barlowtj48/MIDI-Stepper-Motor-Music/(threads)

Thread 2 (2023-11-18):

Request for sample files

richardguerre, 2023-11-18:
Hi @barlowtj48, really cool project! I'm on a Mac so I can't use LoopMidi, so I modified the python script to accept a MIDI file directly, but it's not that fast for experimenting. Do you have the MIDI file you used for the Son of Flynn cover you made on TikTok (so cool btw)?

barlowtj48, 2023-11-18:
Yeah! I added the two Tron tracks that I made, and also the Mario Star Power one too

Closed 2023-11-21.

Thread 4 (2024-01-02):

Problem with 1 channel of CNC shield

DavidShoe, 2024-01-02:
Configured everything (I think), and when I run the sample FL project 3 of the channels (X,Y,Z) all seem to be working as expected.  But the A channel doesn't turn the stepper.

I have swapped the driver module / cables and motor and it seems to be an issue with the A channel configuration.  Is there anything different I need to do with it?

This is a Mega 2560 using a CNC shield and 4 A4988 drivers.

levfo, 2024-01-11:
Having the same issue! Nothing from Channel A

barlowtj48, 2024-01-15:
Sorry for the delay. I will be updating the instructions to note the extra pins that are needed to enable the A stepper driver "direction" and "step" output.

barlowtj48, 2024-01-15:
Added documentation for this issue. Tested and confirmed that without the leads plugged in the "A" driver fails to output.
New photo can be found in [Hardware Assembly Section](https://github.com/barlowtj48/MIDI-Stepper-Motor-Music?tab=readme-ov-file#hardware-assembly)

Closed 2024-01-15.

Thread 6 (2024-01-05):

loopMIDI alternative for Mac or Windows ARM?

Rocky56gh9, 2024-01-05:
Hi - awesome project! I'm running an M2 Mac with Windows 11 ARM installed, and loopMIDI is incompatible with that version of Windows. Do you happen to have any thoughts on alternatives that would work on ARM, either Windows or Mac? Thanks!

Rocky56gh9, 2024-01-05:
I found this, but have no idea where to start if this is even viable.

I just recently got into some home projects for displaying various content sources on epaper screens. Your project looks like a lot of fun but like you suggested, don’t want to commit if there is a fundamental blocker.

https://alternativeto.net/software/hairless-midi--serial-bridge/about/

EJEmmett, 2024-01-05:
From what I can see, Mac also has their own software to do MIDI routing ([MIDI Studio](url)).

There's also [SoundFlower](https://github.com/mattingalls/Soundflower) but it doesn't support M1 chips and hasn't been updated since 2014. I can't verify anything as I don't have a Mac but still worth a look.

[MIDIFire](https://audeonic.com/midifire/) looks like it does virtual routing too but costs $11.99.

Rocky56gh9, 2024-01-05:
And finally got to the end and saw, "Add Mac instructions" on the code page, so that may be my answer!

barlowtj48, 2024-01-15:
> Hi - awesome project! I'm running an M2 Mac with Windows 11 ARM installed, and loopMIDI is incompatible with that version of Windows. Do you happen to have any thoughts on alternatives that would work on ARM, either Windows or Mac? Thanks!

@Rocky56gh9 That's an interesting setup you've got there 😄. I looked around to see if loopMIDI could be rebuilt for different architectures and because it's an old closed source project I don't think there's any chance with that. The "Add Mac instructions" was applicable to users' who were still using MacOS, where there is a built in MIDI virtual output that can be used by the script.

Because you're running Windows on arm64 I don't think there's much that can be done for live output. Regardless, there is a way that you can modify the python script so that instead of opening up a MIDI port, it just opens a single midi file. I've never tested this but believe it might be a workaround. If you're set on using Windows I wouldn't proceed with buying things to make this project, though I've confirmed this setup works fully-featured when using MacOS. Let me know what you think!

Rocky56gh9, 2024-01-15:
Sorry, I was unclear. I’m running MacOS, and in addition I have Win11 ARM virtualized on the same machine. LoopMIDI doesn’t work on that version of Windows. It sounds like I should instead be able to follow the Mac instructions, no?

On Jan 14, 2024, at 11:30 PM, Thomas ***@***.***> wrote:

Hi - awesome project! I'm running an M2 Mac with Windows 11 ARM installed, and loopMIDI is incompatible with that version of Windows. Do you happen to have any thoughts on alternatives that would work on ARM, either Windows or Mac? Thanks!

@Rocky56gh9<https://github.com/Rocky56gh9> That's an interesting setup you've got there 😄. I looked around to see if loopMIDI could be rebuilt for different architectures and because it's an old closed source project I don't think there's any chance with that. The "Add Mac instructions" was applicable to users' who were still using MacOS, where there is a built in MIDI virtual output that can be used by the script.

Because you're running Windows on arm64 I don't think there's much that can be done for live output. Regardless, there is a way that you can modify the python script so that instead of opening up a MIDI port, it just opens a single midi file. I've never tested this but believe it might be a workaround. If you're set on using Windows I wouldn't proceed with buying things to make this project, though I've confirmed this setup works fully-featured when using MacOS. Let me know what you think!

—
Reply to this email directly, view it on GitHub<https://github.com/barlowtj48/MIDI-Stepper-Motor-Music/issues/6#issuecomment-1891284917>, or unsubscribe<https://github.com/notifications/unsubscribe-auth/BE6DIZ7CTGFRHDEAZP6PK7LYOSWFTAVCNFSM6AAAAABBOQFOOSVHI2DSMVQWIX3LMV43OSLTON2WKQ3PNVWWK3TUHMYTQOJRGI4DIOJRG4>.
You are receiving this because you were mentioned.Message ID: ***@***.***>

Rocky56gh9, 2024-01-19:
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

@barlowtj48 , to confirm I am interpreting the Readme correctly, the section about loopMidi and the IAC driver are interchangeable? LoopMidi for Windows and IAC for Mac? If so then I think I’m going to try this!

barlowtj48, 2024-01-20:
@Rocky56gh9 That's perfect! If you're set up to easily switch between the two then I'd send it. The notes that were added actually came from someone else that added those in, and I've since confirmed that the project works well (live) on MacOS and Windows.

Closed 2024-03-01.

Thread 7 (2024-01-20):

What should I do if the stepper motors are wired "incorrectly"?

cartfisk, 2024-01-20:
I ordered six motors and all of them are wired in the "incorrect" configuration where the resistance pins are not adjacent to each other. Is there a way to resolve this issue in software or should I rewire the cables?

barlowtj48, 2024-01-20:
If you have some precision tweezers or maybe a needle, it's possible to pull the connecting pins out of the connector and rewire them like that. I would recommend trying that before chopping any wires or getting into soldering, though either one would work fine

Thread 8 (2024-03-10):

How do you specify a COM port for midi_interface.py on Mac

Infinity465, 2024-03-10:
I've been trying to get everything to work for a while now and the only thing that's given me trouble so far is specifying a COM port. I'm unfamiliar with how it works on Mac. I tried using "/dev/cu.usbmodem143201" instead since that's what the Arduino IDE gives as a comparison to a COM port but it didn't work. I'm probably just missing something but any help would be appreciated!

Infinity465, 2024-03-10:
Figured it out! For some reason, the Arduino was constantly being talked to by the Arduino IDE. Closing that and unplugging it fixed it. I still used/dev/tty.usbmodem143201

Closed 2024-03-10.

Thread 9 (2024-03-11):

Stepper high notes tune down when all 4 steppers are actively playing

Infinity465, 2024-03-11:
I noticed an odd issue while trying to play and tweak midis that have high notes. When a stepper would play the high note solo there would be no issue, but the moment the other three would join in they all would suddenly get pulled down just enough for it to sound out of tune. I'm leaning toward it being a hardware issue however, I used to run another software from jzkmath that I switched away from due to a squeaking issue when starting notes after long rests. I am running a 19.5 volt 6.7 amp power supply that I figured should be enough. I could be just missing something stupid per usual but any feedback helps. I'm using an Arduino Uno R3 with the CNC Shield on top and Creality 42-40 stepper motors.

Here's a sound comparison between all 4 running at once and just 1: [https://youtu.be/dkxyFtzczIY?si=LCLSHSAuBacAnEAc](url)

Please let me know if you need any other information. I'm still new to using GitHub when it comes to anything other than downloading files lol.

Infinity465, 2024-03-11:
https://github.com/barlowtj48/MIDI-Stepper-Motor-Music/assets/32528367/41f89158-6be4-447e-8a94-d6eb595b674b

Here's an embed of the video incase the link breaks.

Infinity465, 2024-03-12:
I believe that I may have fixed it. I used another Uno R3 and was still running into the issue, but out of sheer curiosity, I tried my Uno R4 and the issue disappeared. Not quite sure why that's the case but it worked for me.

Closed 2024-03-12.

Thread 10 (2024-04-07):

AttributeError: 'Message' object has no attribute '. Help

Kr666you, 2024-04-07:
Script connected to Arduino with 2 motors.
[?] Choose MIDI port:
 > loopMIDI Port 0

Listening for MIDI input...
Ports closed.
Traceback (most recent call last):
  File "C:\Users\user\Documents\1pi\MIDI-Stepper-Motor-Music-main\midi_interface.py", line 179, in <module>
    motor_index = msg.channel
                  ^^^^^^^^^^^
AttributeError: 'Message' object has no attribute '

Help

Kr666you, 2024-04-09:
I found out that when i use a different app than fl studio it works but when i print(msg.channel) it prints out the correct channel but when the code prints out the note frequency it also prints out that the msg.channel is 0. so basicly it keeps thinking that the channel is 0 all the time

Closed 2024-04-09.

Thread 11 (2024-04-09):

Code keeps thinking that the channel is always 0 (channel 1)

Kr666you, 2024-04-09:
so i kept seeing that the script would only use 1 motor. i did some digging and ended up adding "print(msg.channel)" to the code.
then in the console i saw that print(msg.channel) would print out the correct channel but the original print(print_str) would keep printing out the wrong channel. not only it would print out the wrong channel but use the wrong channel. help.

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

Kr666you, 2024-04-09:
im so dumb lmao i trought that thwe code was broken but i didnt know that the code uses channel 3 for STEP_Y but i trought that it used channel 1 for motor 1 (x), channel 2 for motor 2 (y), channel 3 for motor 3 (z) and channel 4 for motor 4 (A)

Thread 12 (2024-08-09):

Mapping Between MIDI Channels And Stepper Motors

swiz23, 2024-08-09:
Hi,

Thanks for creating this repo! This isn't so much an issue than a question. Is there somewhere in the documentation that shows the mapping between MIDI channels and stepper motors? I think that could be helpful as a check to make sure my project is working out correctly.

Also, as a different question, is there a free MIDI editor that you'd recommend? I was playing around with MuseCore (which has a great UI) but it looks like it doesn't do a good job of separating out multiple channels when outputting to a single MIDI port (though maybe I missed something). Cakewalk does separate out multiple channels, but the UI is a little daunting.

Thanks

barlowtj48, 2024-09-16:
As far as the channels go, it is mostly as it is defined at the top of [midi_interface.ino](https://github.com/barlowtj48/MIDI-Stepper-Motor-Music/blob/021ba0ee32a4f8101e92716dce6a4c5749eaf742/midi_interface/midi_interface_4_motors.ino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)
Channel 1: X axis
Channel 2: Z axis
Channel 3: Y axis
Channel 4: A Axis

I don't have a good free MIDI editor unfortunately. I personally use FL studio, but I would say if you've found something else that supports it then it might be worth just crushing some YouTube videos to see if you can get going with that.

swiz23, 2024-09-26:
Thanks

Closed 2024-09-26.

Thread 13 (2025-01-26):

Broken on W11 24H2

TehH4rRy, 2025-01-26:
Not sure if this is a LoopMidi problem or what, but I was forced onto W11 24H2 (Thanks Microsoft) and now whenever I play MIDI files they just come out my PC speakers.

The script detects the midi port and my arduino fine. Reinstalled LoopMidi...not sure what else to try?

barlowtj48, 2025-01-26:
When you are playing the MIDI files, what software are you using?

barlowtj48, 2025-01-27:
Interesting. My understanding of windows media player is slim at best, besides knowing it is very very outdated. I would recommend looking around for some other freeware MIDI editors to use that you can more easily configure the files rather than just a one-shot playback. I know that's not too helpful but non-configurable software that stops working doesn't leave a lot of room for fixes to be made.

TehH4rRy, 2025-01-28:
Ah I tried a few different programs to play MIDI but they just come out my speakers, even rolled back the 24H2 Update as well. The driver in LoopMidi is unchanged. Seems it's broken the way MIDI is routed to LoopMIDI.

Oh well, I had a bit of fun with this project. I've got the hardware, guess I find one which works on Linux.
