barlowtj48/MIDI-Stepper-Motor-Music/(commit log)

2023-11-11 Make python more generic and operate with ack to ensure connection quality and motor channel setup correct
    [midi_interface.py]
2023-11-14 Add sample FL Studio Project
2023-11-14 Code cleanup plus add missing library dependency
    [midi_interface.py]
2023-11-17 Opened up more channels can preserve more notes, still need to crunch down to a variable number of channels for motor limits
2023-11-17 Fix stutter in serial communication causing strange timing issues - No change to the arduino is necessary
    [midi_interface.py]
2023-11-17 Fix motor sleep + add cool printing
    [midi_interface.py]
2023-11-18 Add sample files
2023-11-29 Add Mac instructions
    Update README with info on how to setup the MIDI device on Mac.
    Remove hard coded LoopMIDI filter in midi_interface and instead give the
    user a prompt to select their MIDI interface from the ones found.
2023-12-05 Enable pitch bending for motor-fine tuning within a midi track. This is not to be used with a live keyboard setup, it will sound terribly
2023-12-22 Catch the case if the Arduino is connected correctly, but the ino is wrong so it never actually connects but no errors
    [midi_interface.py]
2024-01-12 Update docs + ino files for 5th motor configuration
2024-01-15 Fix for issue #4, no documented notes on enabling "A" motor.
2024-03-05 Add subheader so 4th motor is linkable
